WillB97/lipo-chg-eval-pcb/readme.md

# BQ25792/MP2759 LiPo Charger Evaluation Board



[GitHub Pages site](https://willb97.github.io/lipo-chg-eval-pcb/Browse/charger-compare-navigate.html).
