WillB97/lipo-chg-eval-pcb/charger-compare.kicad_pcb

## KiCad design charger-compare.kicad_pcb (2025-10-16)

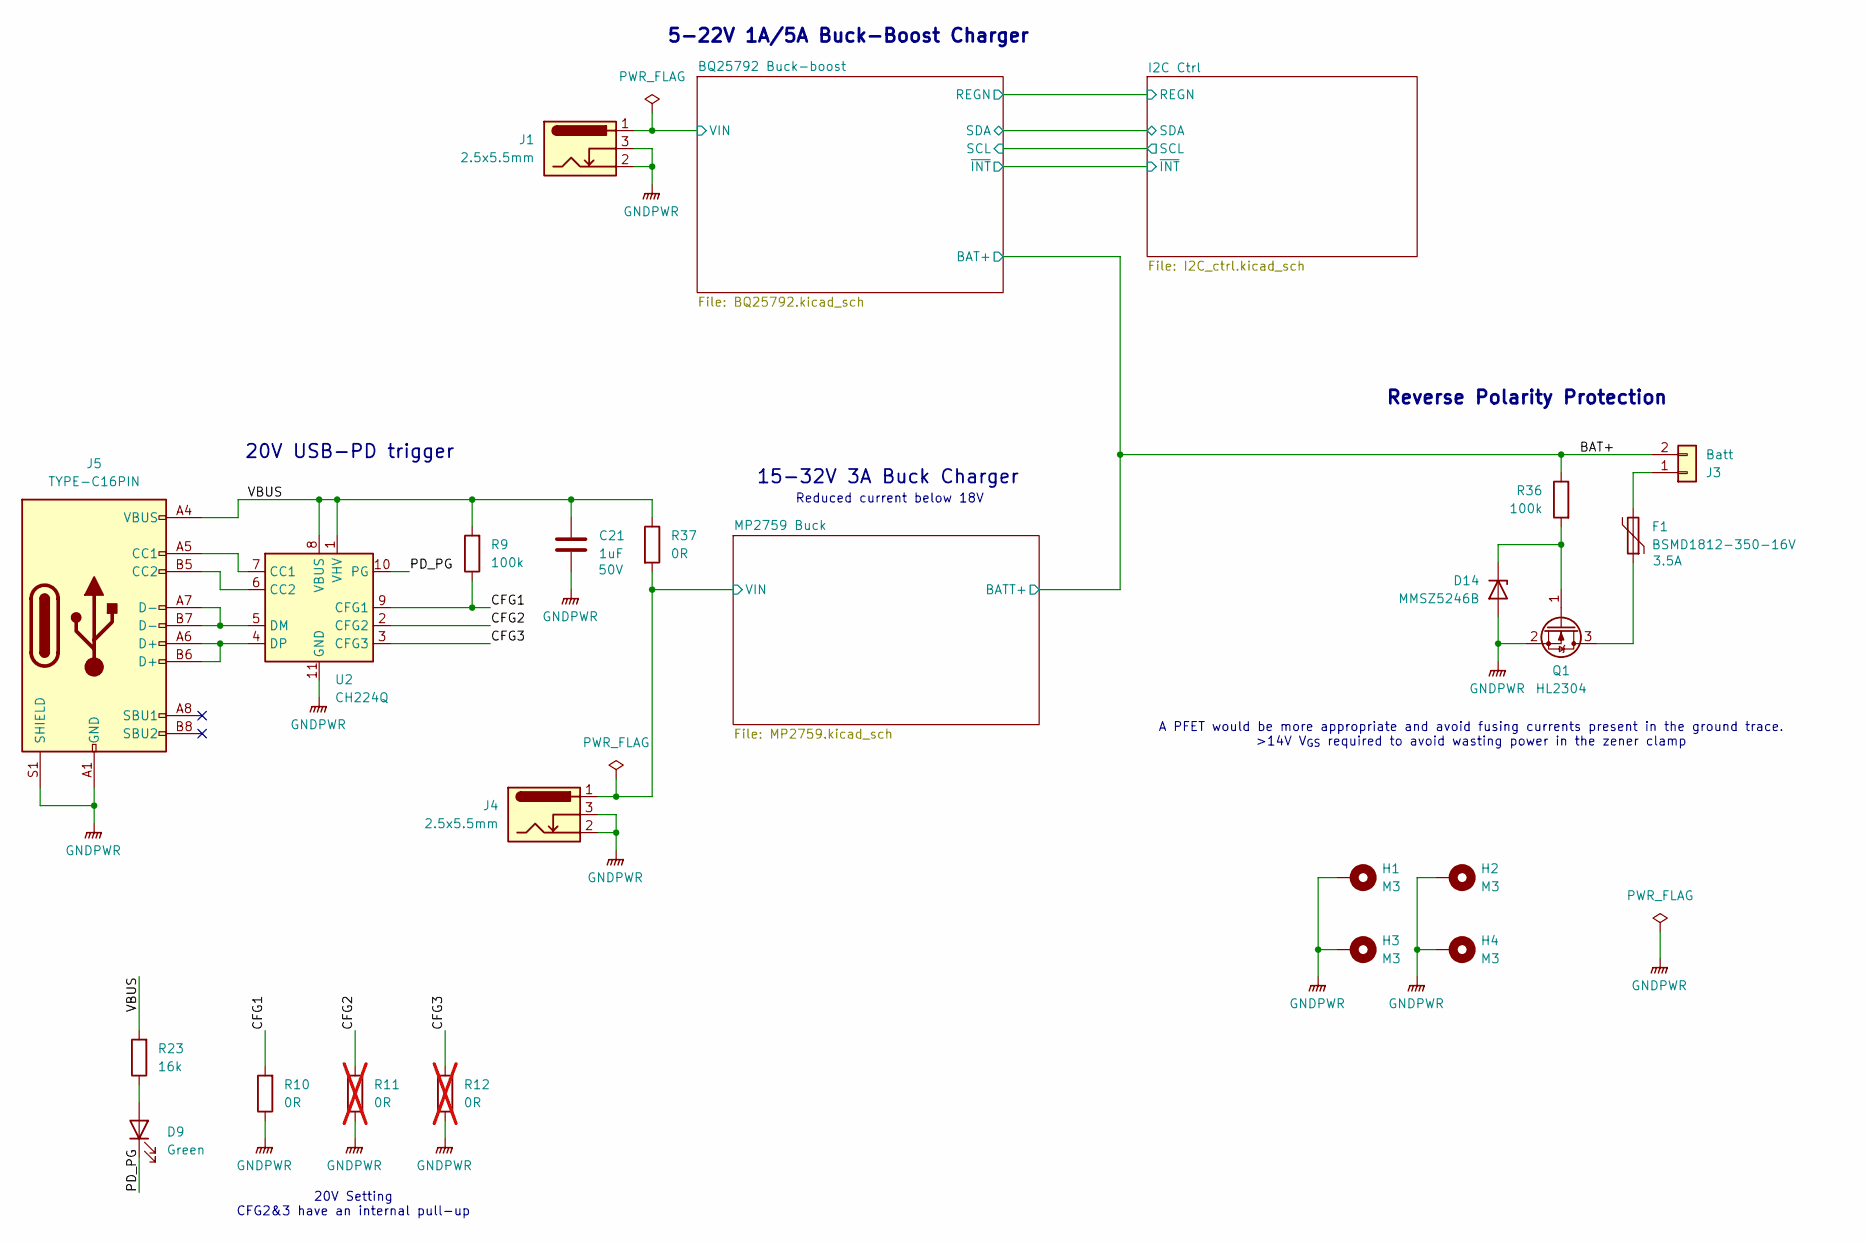
[picture p1: schematic charger-compare.kicad_sch, 3S LiPo Charger Test Board]

Parts:
C21: 1uF; C_0603_1608Metric; Voltage 50V; JLC C15849
D9: Green; LED_0805_2012Metric; JLC C2297
D14: MMSZ5246B; D_SOD-123; LCSC C19077429
F1: BSMD1812-350-16V; Fuse_1812_4532Metric_Pad1.30x3.40mm_HandSolder; Rating 3.5A; LCSC C5301865
H1, H2, H3, H4: M3; MountingHole_3.2mm_M3_Pad
J1, J4: 2.5x5.5mm; DC005-2.5; LCSC C7507454
J3: Batt; AMASS_XT60-M_1x02_P7.20mm_Vertical
J5: TYPE-C16PIN; USB_C_Receptacle_Palconn_UTC16-G; LCSC C393939
Q1: HL2304; SOT-23; LCSC C7420346
R9, R36: 100k; R_0402_1005Metric
R10: 0R; R_0603_1608Metric
R11, R12: 0R; R_0603_1608Metric; not fitted
R23: 16k; R_0402_1005Metric
R37: 0R; R_1206_3216Metric
U2: CH224Q; DFN-10_2x2mm_P0.4mm; LCSC C46061833

Connections:
/BAT+: J3.2, R36.1; also elsewhere on the board
/CFG1: R9.1, R10.2, U2.9 (CFG1)
/CFG2: R11.2, U2.2 (CFG2)
/CFG3: R12.2, U2.3 (CFG3)
/MP2759 Buck/VIN: J4.1, R37.2; also elsewhere on the board
/PD_PG: D9.1 (K), U2.10 (PG)
/VBUS: C21.1, J5.A4 (VBUS), J5.A9 (VBUS), J5.B4 (VBUS), J5.B9 (VBUS), R9.2, R23.2, R37.1, U2.1 (VHV), U2.8 (VBUS)
GNDPWR: C21.2, D14.2 (A), H1.1, H2.1, H3.1, H4.1, J1.2, J1.3, J4.2, J4.3, J5.A1 (GND), J5.A12 (GND), J5.B1 (GND), J5.B12 (GND), J5.S1 (SHIELD), Q1.2 (S), R10.1, R11.1, R12.1, U2.11 (GND); also elsewhere on the board
unnamed: D9.2 (A), R23.1
unnamed: D14.1 (K), Q1.1 (G), R36.2
unnamed: F1.2, J3.1
unnamed: J5.A5 (CC1), U2.7 (CC1)
unnamed: J5.B5 (CC2), U2.6 (CC2)
unnamed: F1.1, Q1.3 (D)
unnamed: J5.A7 (D-), J5.B7 (D-), U2.5 (DM)
unnamed: J5.A6 (D+), J5.B6 (D+), U2.4 (DP)
VBUS: J1.1; also elsewhere on the board

Notes on the sheet:
20V USB-PD trigger
Reverse Polarity Protection
5-22V 1A/5A Buck-Boost Charger
A PFET would be more appropriate and avoid fusing currents present in the ground trace. >14V V_{GS} required to avoid wasting power in the zener clamp
20V Setting CFG2&3 have an internal pull-up
Reduced current below 18V
15-32V 3A Buck Charger

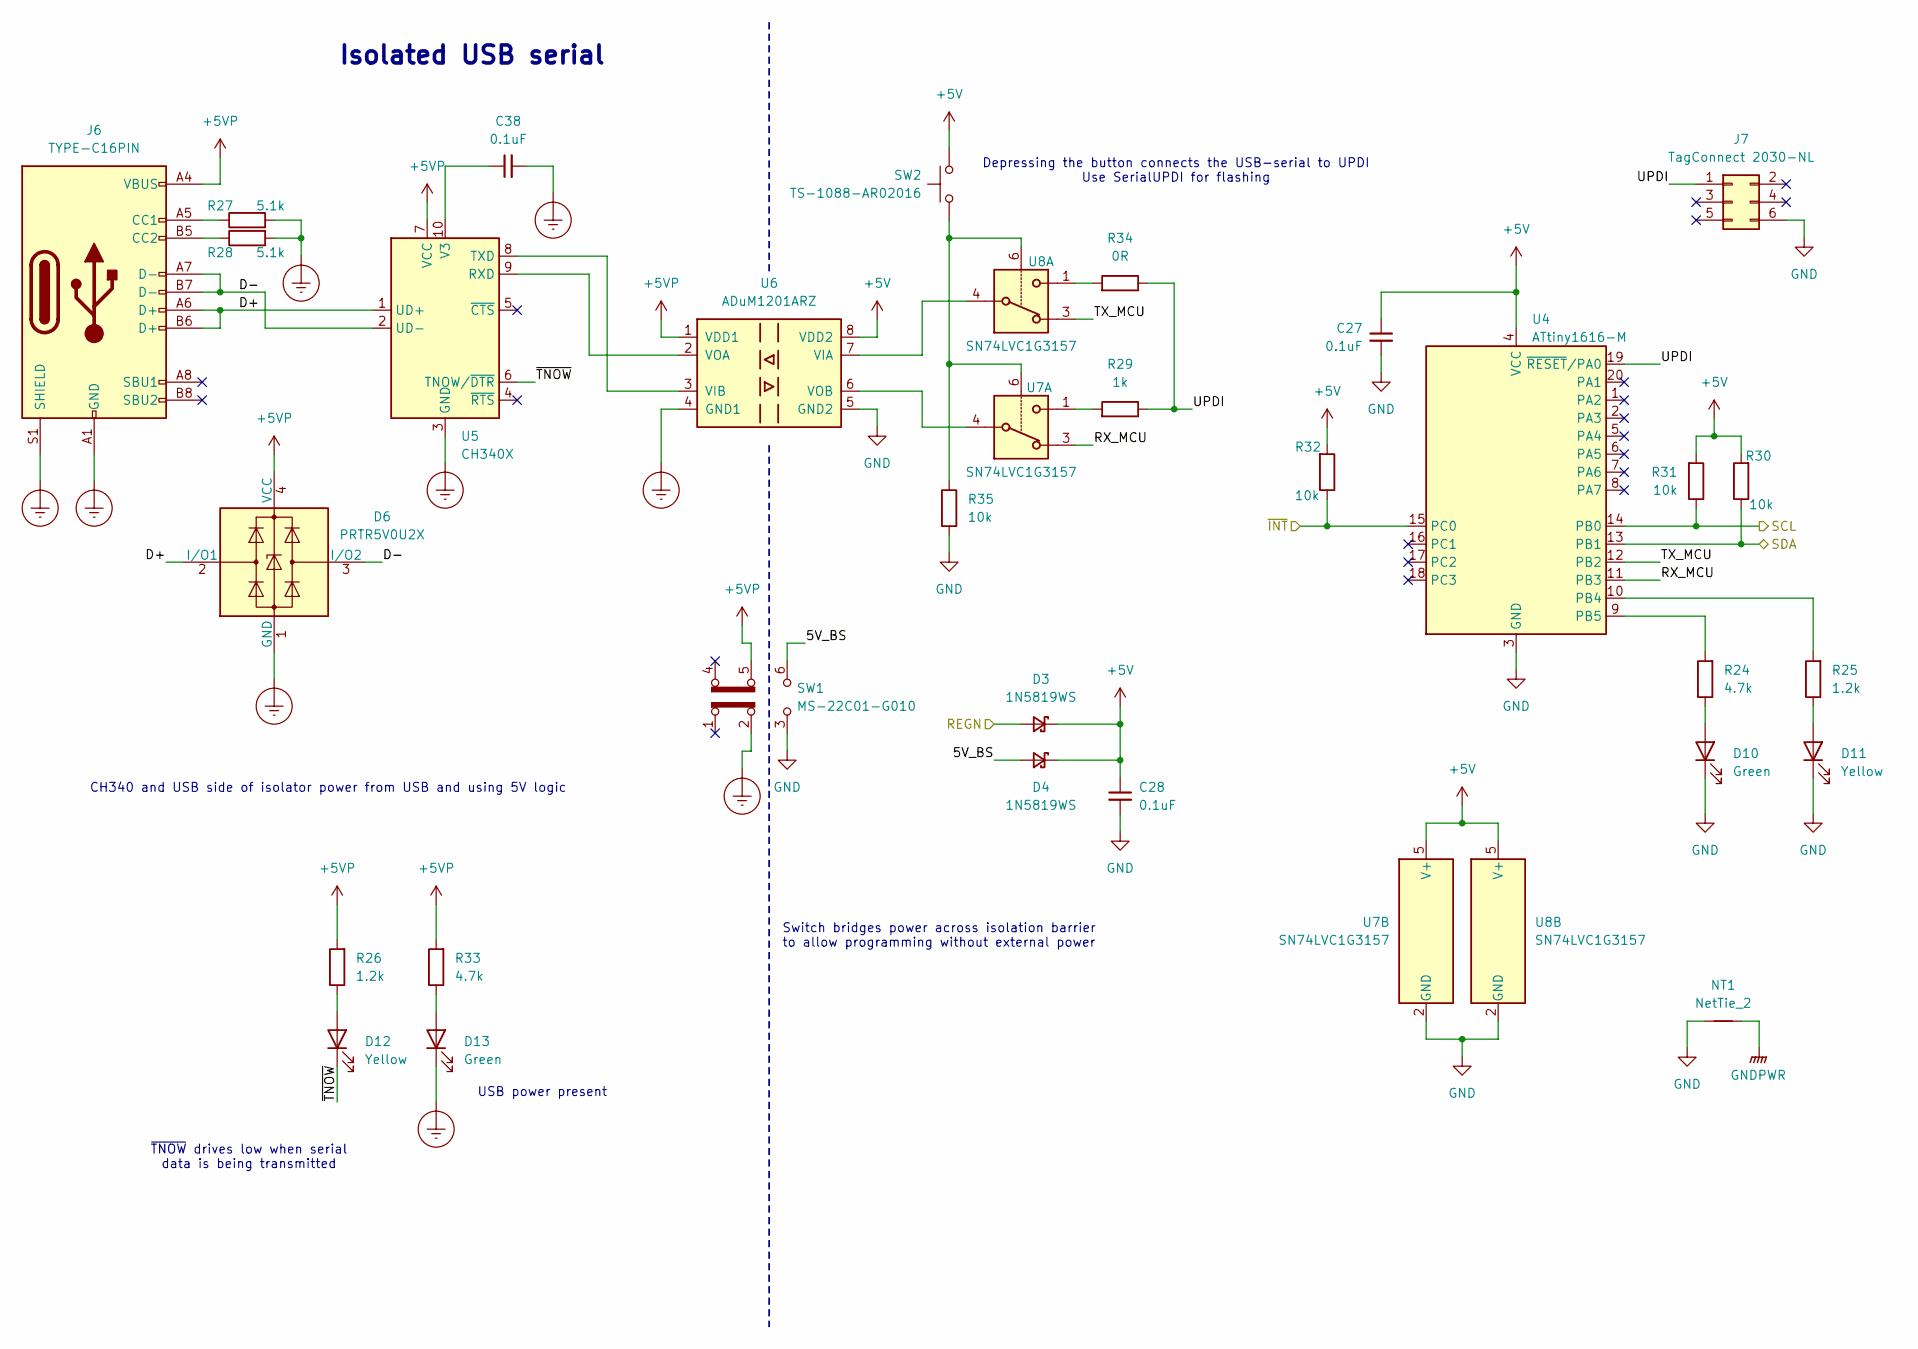
[picture p2: schematic I2C_ctrl.kicad_sch, Control MCU with Isolated USB-Serial Interface]

Parts:
C27, C28, C38: 0.1uF; C_0402_1005Metric; Voltage 10V; JLC C307331
D3, D4: 1N5819WS; D_SOD-323; JLC C191023
D6: PRTR5V0U2X; SOT-143; LCSC C5158049
D10, D13: Green; LED_0805_2012Metric; JLC C2297
D11, D12: Yellow; LED_0805_2012Metric; JLC C2296
J6: TYPE-C16PIN; USB_C_Receptacle_Palconn_UTC16-G; LCSC C393939
J7: TagConnect 2030-NL; Tag-Connect_TC2030-IDC-NL_2x03_P1.27mm_Vertical
NT1: NetTie_2; NetTie-2_SMD_Pad0.5mm
R24, R33: 4.7k; R_0402_1005Metric
R25, R26: 1.2k; R_0402_1005Metric
R27, R28: 5.1k; R_0402_1005Metric
R29: 1k; R_0402_1005Metric
R30, R31, R32, R35: 10k; R_0402_1005Metric
R34: 0R; R_0603_1608Metric
SW1: MS-22C01-G010; SW_DPDT_MS-22C01-G010
SW2: TS-1088-AR02016; SW_Push_SPST_JLC_Basic; JLC C720477
U4: ATtiny1616-M; VQFN-20-1EP_3x3mm_P0.4mm_EP1.7x1.7mm; LCSC C507118
U5: CH340X; MSOP-10_3x3mm_P0.5mm; LCSC C3035748
U6: ADuM1201ARZ; SOIC-8_3.9x4.9mm_P1.27mm; LCSC C9669
U7, U8: SN74LVC1G3157; SOT-363_SC-70-6; LCSC C36533656

Connections:
+5V: C27.1, C28.1, D3.1 (K), D4.1 (K), R30.2, R31.2, R32.2, SW2.2, U4.4 (VCC), U6.8 (VDD2), U7.5 (V+), U8.5 (V+)
+5VP: D6.4 (VCC), J6.A4 (VBUS), J6.A9 (VBUS), J6.B4 (VBUS), J6.B9 (VBUS), R26.2, R33.2, SW1.5 (B), U5.7 (VCC), U6.1 (VDD1)
/BQ25792 Buck-boost/REGN: D3.2 (A); also elsewhere on the board
/BQ25792 Buck-boost/SCL: R31.1, U4.14 (PB0); also elsewhere on the board
/BQ25792 Buck-boost/SDA: R30.1, U4.13 (PB1); also elsewhere on the board
/BQ25792 Buck-boost/~INT: R32.1, U4.15 (PC0); also elsewhere on the board
/I2C Ctrl/5V_BS: D4.2 (A), SW1.6 (C)
/I2C Ctrl/D+: D6.2 (I/O1), J6.A6 (D+), J6.B6 (D+), U5.1 (UD+)
/I2C Ctrl/D-: D6.3 (I/O2), J6.A7 (D-), J6.B7 (D-), U5.2 (UD-)
/I2C Ctrl/RX_MCU: U4.11 (PB3), U7.3
/I2C Ctrl/TX_MCU: U4.12 (PB2), U8.3
/I2C Ctrl/UPDI: J7.1, R29.1, R34.1, U4.19 (~RESET/PA0)
/I2C Ctrl/~TNOW: D12.1 (K), U5.6 (TNOW/~DTR)
Earth_Protective: C38.2, D6.1 (GND), D13.1 (K), J6.A1 (GND), J6.A12 (GND), J6.B1 (GND), J6.B12 (GND), J6.S1 (SHIELD), R27.2, R28.2, SW1.2 (B), U5.3 (GND), U6.4 (GND1)
GND: C27.2, C28.2, D10.1 (K), D11.1 (K), J7.6, NT1.1, R35.2, SW1.3 (C), U4.3 (GND), U4.21 (GND), U6.5 (GND2), U7.2 (GND), U8.2 (GND)
GNDPWR: NT1.2; also elsewhere on the board
unnamed: D10.2 (A), R24.1
unnamed: D11.2 (A), R25.1
unnamed: D12.2 (A), R26.1
unnamed: D13.2 (A), R33.1
unnamed: J6.A5 (CC1), R27.1
unnamed: J6.B5 (CC2), R28.1
unnamed: R29.2, U7.1
unnamed: R34.2, U8.1
unnamed: R35.1, SW2.1, U7.6, U8.6
unnamed: R25.2, U4.10 (PB4)
unnamed: R24.2, U4.9 (PB5)
unnamed: U5.9 (RXD), U6.2 (VOA)
unnamed: U5.8 (TXD), U6.3 (VIB)
unnamed: C38.1, U5.10 (V3)
unnamed: U6.7 (VIA), U8.4
unnamed: U6.6 (VOB), U7.4

Notes on the sheet:
~{TNOW} drives low when serial data is being transmitted
Depressing the button connects the USB-serial to UPDI Use SerialUPDI for flashing
Switch bridges power across isolation barrier to allow programming without external power
USB power present
Isolated USB serial
CH340 and USB side of isolator power from USB and using 5V logic

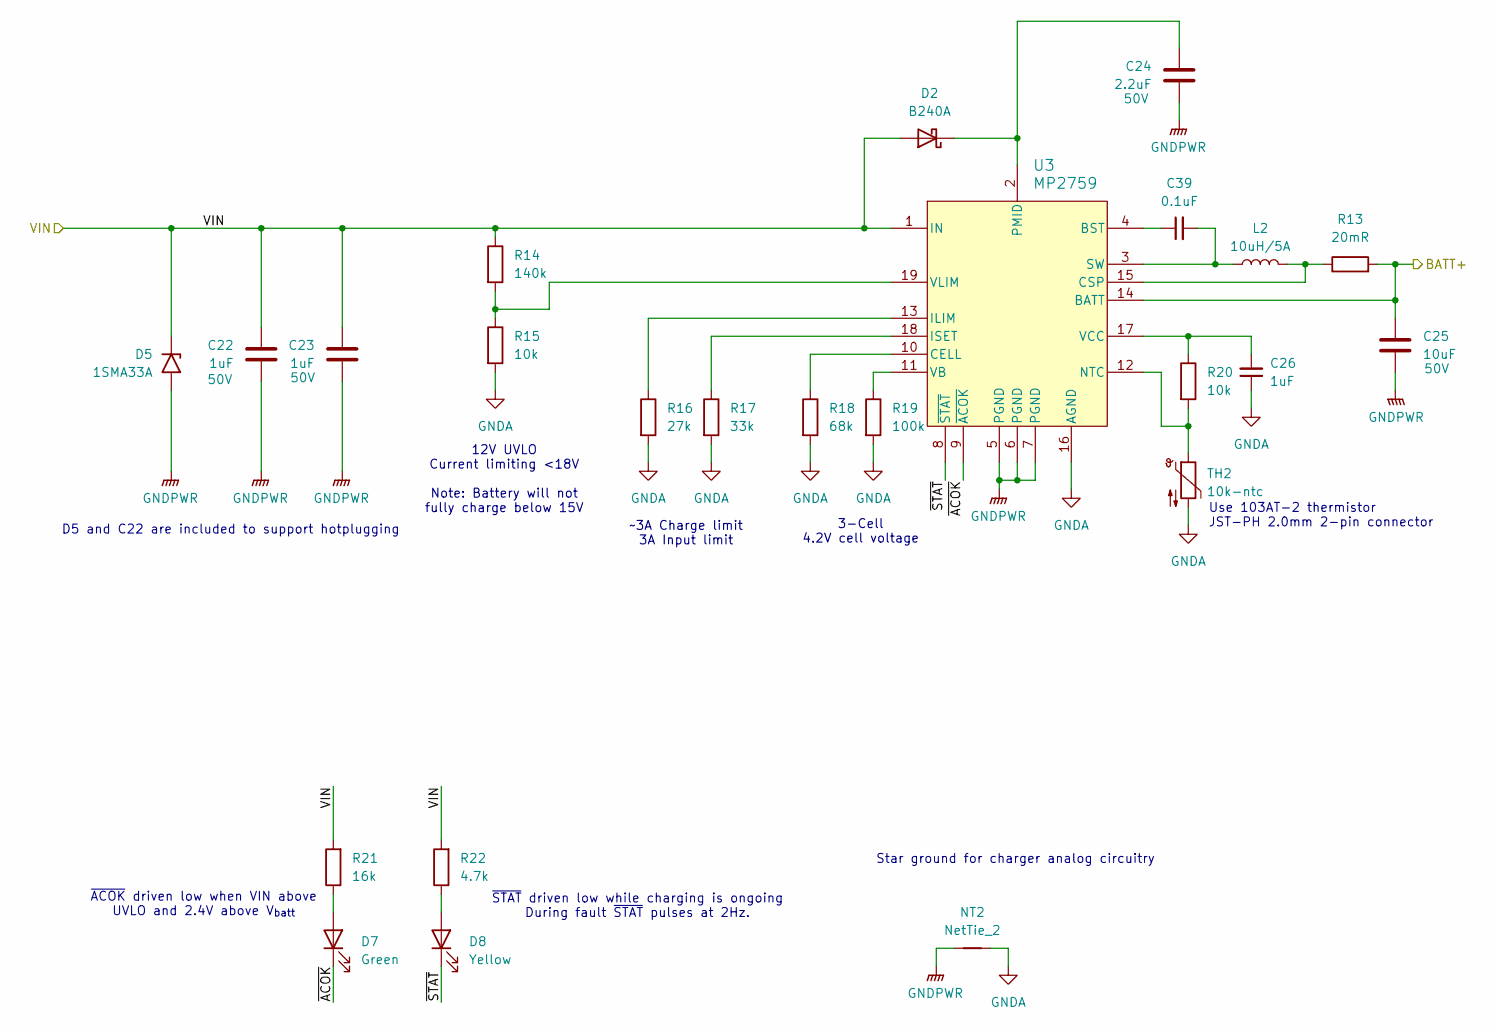
[picture p3: schematic MP2759.kicad_sch, MP2759 Buck Charger]

Parts:
C22, C23: 1uF; C_0603_1608Metric; Voltage 50V; JLC C15849
C24: 2.2uF; C_0805_2012Metric; Voltage 50V; JLC C377773
C25: 10uF; C_0805_2012Metric; Voltage 50V; JLC C440198
C26: 1uF; C_0603_1608Metric; Voltage 10V; JLC C15849
C39: 0.1uF; C_0402_1005Metric; Voltage 10V; JLC C307331
D2: B240A; D_SMA; LCSC C39358
D5: 1SMA33A; D_SMA; LCSC C1975650
D7: Green; LED_0805_2012Metric; JLC C2297
D8: Yellow; LED_0805_2012Metric; JLC C2296
L2: 10uH/5A; L_Bourns_SRP7028A_7.3x6.6mm; LCSC C32712974
NT2: NetTie_2; NetTie-2_SMD_Pad0.5mm
R13: 20mR; R_1206_3216Metric; LCSC C393094
R14: 140k; R_0402_1005Metric; LCSC C2998127
R15, R20: 10k; R_0402_1005Metric
R16: 27k; R_0603_1608Metric
R17: 33k; R_0402_1005Metric
R18: 68k; R_0603_1608Metric
R19: 100k; R_0402_1005Metric
R21: 16k; R_0402_1005Metric
R22: 4.7k; R_0402_1005Metric
TH2: 10k-ntc; JST_PH_B2B-PH-K_1x02_P2.00mm_Vertical
U3: MP2759; QFN-19_MP2759_MNP; LCSC C3682359

Connections:
/BAT+: C25.1, R13.2, U3.14 (BATT); also elsewhere on the board
/MP2759 Buck/VIN: C22.1, C23.1, D2.2 (A), D5.1 (A1), R14.1, R21.2, R22.2, U3.1 (IN); also elsewhere on the board
/MP2759 Buck/~ACOK: D7.1 (K), U3.9 (~ACOK)
/MP2759 Buck/~STAT: D8.1 (K), U3.8 (~STAT)
GNDA: C26.1, NT2.2, R15.2, R16.2, R17.2, R18.2, R19.2, TH2.2, U3.16 (AGND)
GNDPWR: C22.2, C23.2, C24.2, C25.2, D5.2 (A2), NT2.1, U3.5 (PGND), U3.6 (PGND), U3.7 (PGND); also elsewhere on the board
unnamed: C24.1, D2.1 (K), U3.2 (PMID)
unnamed: D7.2 (A), R21.1
unnamed: D8.2 (A), R22.1
unnamed: C39.1, U3.4 (BST)
unnamed: R18.1, U3.10 (CELL)
unnamed: L2.2, R13.1, U3.15 (CSP)
unnamed: R16.1, U3.13 (ILIM)
unnamed: R17.1, U3.18 (ISET)
unnamed: R20.2, TH2.1, U3.12 (NTC)
unnamed: C39.2, L2.1, U3.3 (SW)
unnamed: R19.1, U3.11 (VB)
unnamed: C26.2, R20.1, U3.17 (VCC)
unnamed: R14.2, R15.1, U3.19 (VLIM)

Notes on the sheet:
~3A Charge limit 3A Input limit
3-Cell 4.2V cell voltage
Use 103AT-2 thermistor JST-PH 2.0mm 2-pin connector
D5 and C22 are included to support hotplugging
~{STAT} driven low while charging is ongoing During fault ~{STAT} pulses at 2Hz.
~{ACOK} driven low when VIN above UVLO and 2.4V above V_{batt}
12V UVLO Current limiting <18V Note: Battery will not fully charge below 15V
Star ground for charger analog circuitry

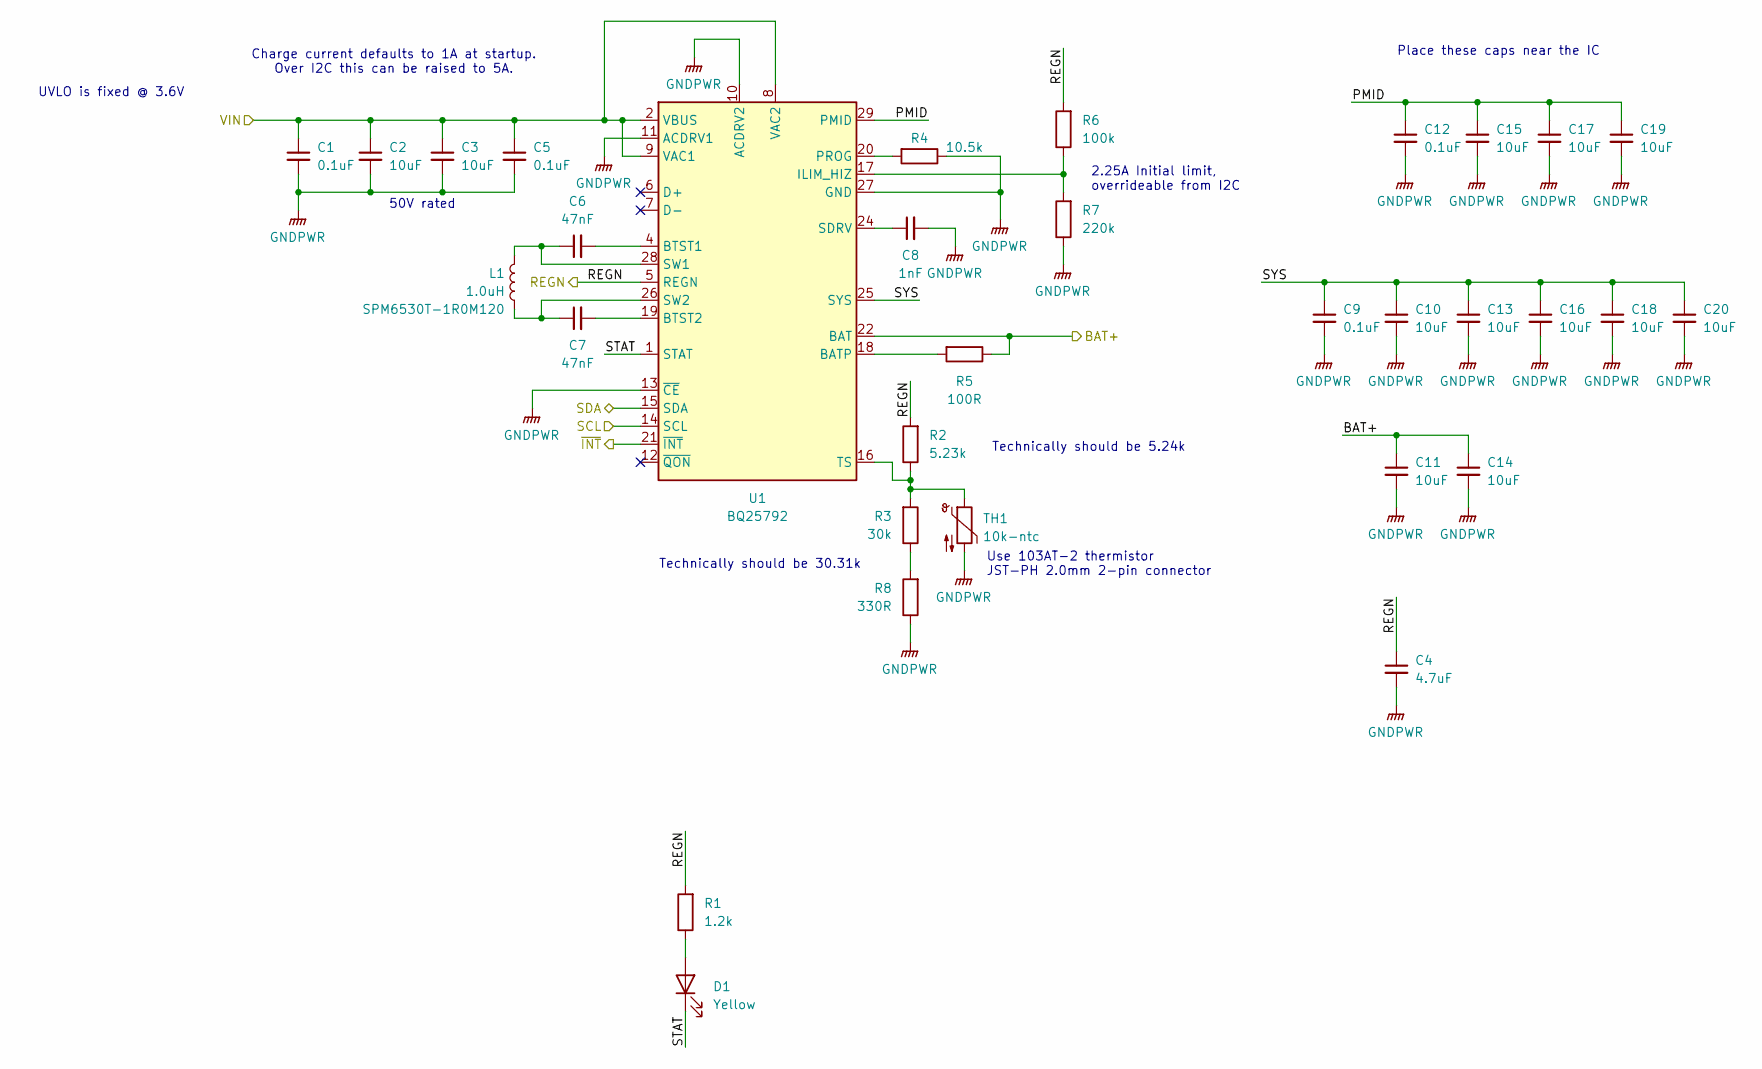
[picture p4: schematic BQ25792.kicad_sch, BQ25792 Buck-Boost Charger]

Parts:
C1, C5, C9, C12: 0.1uF; C_0402_1005Metric; Voltage 50V; JLC C307331
C2, C3: 10uF; C_0805_2012Metric; Voltage 50V; JLC C440198
C4: 4.7uF; C_0402_1005Metric; Voltage 6.3V; JLC C23733
C6, C7: 47nF; C_0402_1005Metric; Voltage 50V; LCSC C307339
C8: 1nF; C_0402_1005Metric; Voltage 50V; JLC C1523
C10, C11, C13, C14, C15, C16, C17, C18, C19, C20: 10uF; C_0805_2012Metric; Voltage 25V; JLC C15850
D1: Yellow; LED_0805_2012Metric; JLC C2296
L1: 1.0uH; TDK-SPM6530T; LCSC C87572
R1: 1.2k; R_0402_1005Metric
R2: 5.23k; R_0603_1608Metric; LCSC C5140106
R3: 30k; R_0603_1608Metric
R4: 10.5k; R_0603_1608Metric; LCSC C100712
R5: 100R; R_0402_1005Metric
R6: 100k; R_0402_1005Metric
R7: 220k; R_0603_1608Metric
R8: 330R; R_0402_1005Metric
TH1: 10k-ntc; JST_PH_B2B-PH-K_1x02_P2.00mm_Vertical
U1: BQ25792; VQFN29-HR; LCSC C2862876

Connections:
/BAT+: C11.1, C14.1, R5.1, U1.22 (BAT), U1.23 (BAT); also elsewhere on the board
/BQ25792 Buck-boost/PMID: C12.1, C15.1, C17.1, C19.1, U1.29 (PMID)
/BQ25792 Buck-boost/REGN: C4.1, R1.2, R2.2, R6.2, U1.5 (REGN); also elsewhere on the board
/BQ25792 Buck-boost/SCL: U1.14 (SCL); also elsewhere on the board
/BQ25792 Buck-boost/SDA: U1.15 (SDA); also elsewhere on the board
/BQ25792 Buck-boost/STAT: D1.1 (K), U1.1 (STAT)
/BQ25792 Buck-boost/SYS: C9.1, C10.1, C13.1, C16.1, C18.1, C20.1, U1.25 (SYS)
/BQ25792 Buck-boost/~INT: U1.21 (~INT); also elsewhere on the board
GNDPWR: C1.2, C2.2, C3.2, C4.2, C5.2, C8.2, C9.2, C10.2, C11.2, C12.2, C13.2, C14.2, C15.2, C16.2, C17.2, C18.2, C19.2, C20.2, R4.1, R7.1, R8.1, TH1.2, U1.10 (ACDRV2), U1.11 (ACDRV1), U1.13 (~CE), U1.27 (GND); also elsewhere on the board
unnamed: D1.2 (A), R1.1
unnamed: R3.1, R8.2
unnamed: R5.2, U1.18 (BATP)
unnamed: C6.2, U1.4 (BTST1)
unnamed: C7.2, U1.19 (BTST2)
unnamed: R6.1, R7.2, U1.17 (ILIM_HIZ)
unnamed: R4.2, U1.20 (PROG)
unnamed: C8.1, U1.24 (SDRV)
unnamed: C6.1, L1.1, U1.28 (SW1)
unnamed: C7.1, L1.2, U1.26 (SW2)
unnamed: R2.1, R3.2, TH1.1, U1.16 (TS)
VBUS: C1.1, C2.1, C3.1, C5.1, U1.2 (VBUS), U1.3 (VBUS), U1.8 (VAC2), U1.9 (VAC1); also elsewhere on the board

Notes on the sheet:
UVLO is fixed @ 3.6V
2.25A Initial limit, overrideable from I2C
Place these caps near the IC
Use 103AT-2 thermistor JST-PH 2.0mm 2-pin connector
Technically should be 30.31k
50V rated
Charge current defaults to 1A at startup. Over I2C this can be raised to 5A.
Technically should be 5.24k

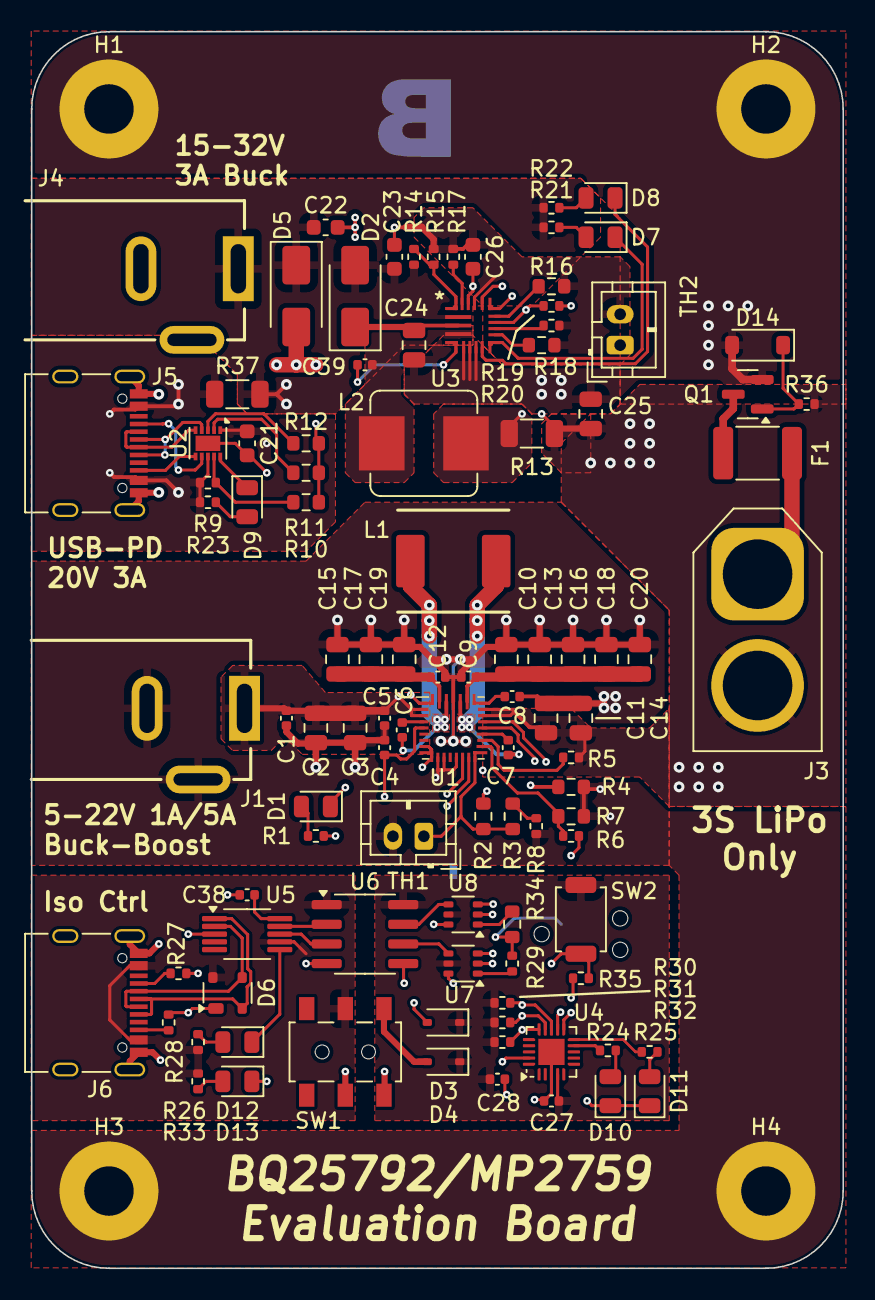
[picture p5: board charger-compare.kicad_pcb from above]

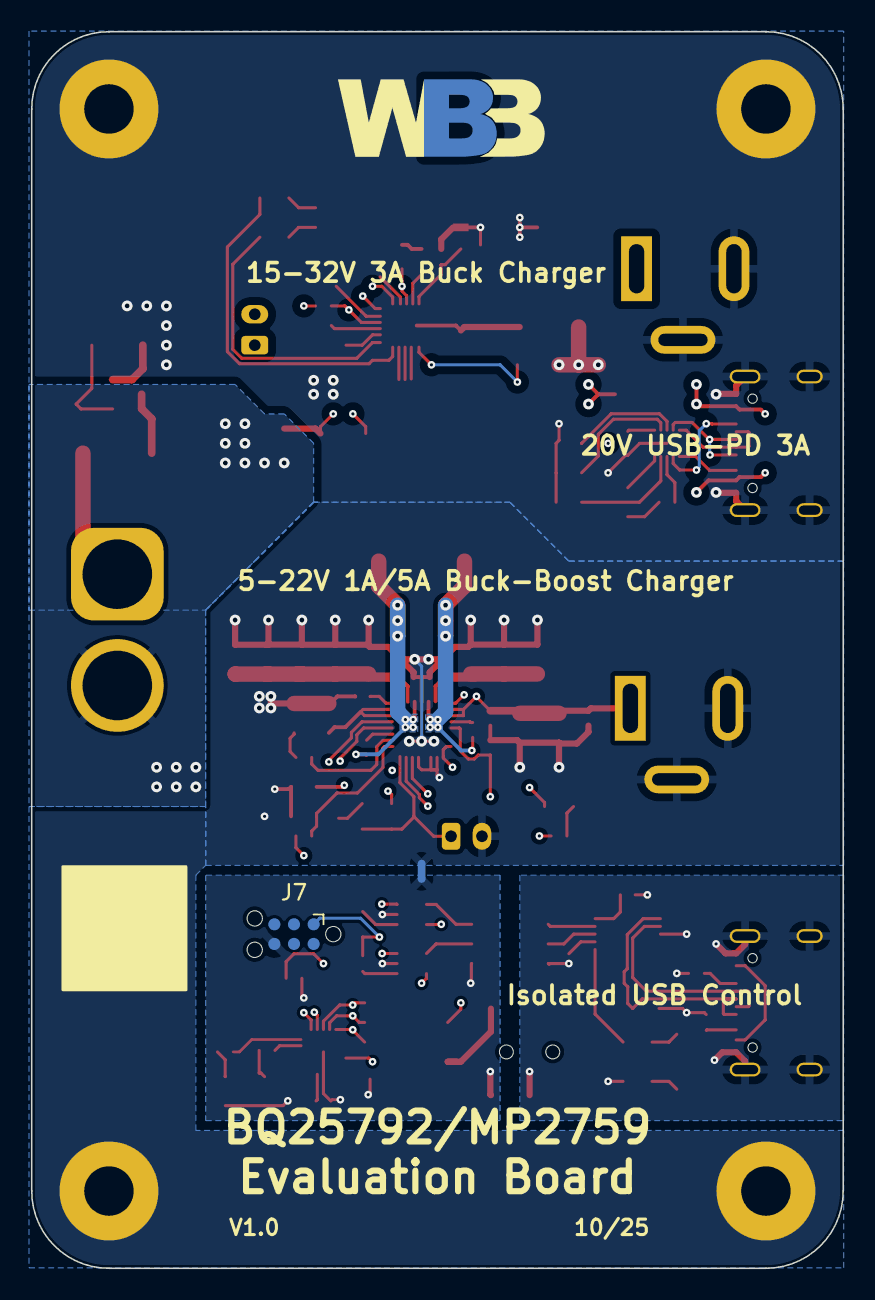
[picture p6: board charger-compare.kicad_pcb from below]

Board: 4 copper layers, 52.5 x 80.0 mm, 110 parts (3 on the bottom side), 78 nets.

Other parts of the board:
LBL1: WBB
