WillB97/lipo-chg-eval-pcb/(commit log)

2025-10-05 Initial design
    [BQ25792.kicad_sch, I2C_ctrl.kicad_sch, MP2759.kicad_sch, charger-compare.kicad_pcb, charger-compare.kicad_sch]
2025-10-05 More fixes
    [BQ25792.kicad_sch, I2C_ctrl.kicad_sch, MP2759.kicad_sch, charger-compare.kicad_pcb, charger-compare.kicad_sch]
2025-10-06 Fix reference
    [charger-compare.kicad_pcb]
2025-10-07 Set LED resistors
    [BQ25792.kicad_sch, I2C_ctrl.kicad_sch, MP2759.kicad_sch, charger-compare.kicad_pcb, charger-compare.kicad_sch]
2025-10-09 Switch to JST-PH connectors Add Sheet titles
    [BQ25792.kicad_sch, I2C_ctrl.kicad_sch, MP2759.kicad_sch, charger-compare.kicad_pcb, charger-compare.kicad_sch]
2025-10-15 Action review feedback
    [BQ25792.kicad_sch, I2C_ctrl.kicad_sch, MP2759.kicad_sch, charger-compare.kicad_pcb, charger-compare.kicad_sch]
2025-10-16 Add JLC QR code location
    [charger-compare.kicad_pcb]
2025-10-16 Omit tagconnect for BOM
    [I2C_ctrl.kicad_sch, charger-compare.kicad_pcb]
2025-10-16 Add V1.0 date
    [BQ25792.kicad_sch, I2C_ctrl.kicad_sch, MP2759.kicad_sch, charger-compare.kicad_pcb, charger-compare.kicad_sch]
